jalcok1/practicum/images/Da_Brains_Assembled.jpg

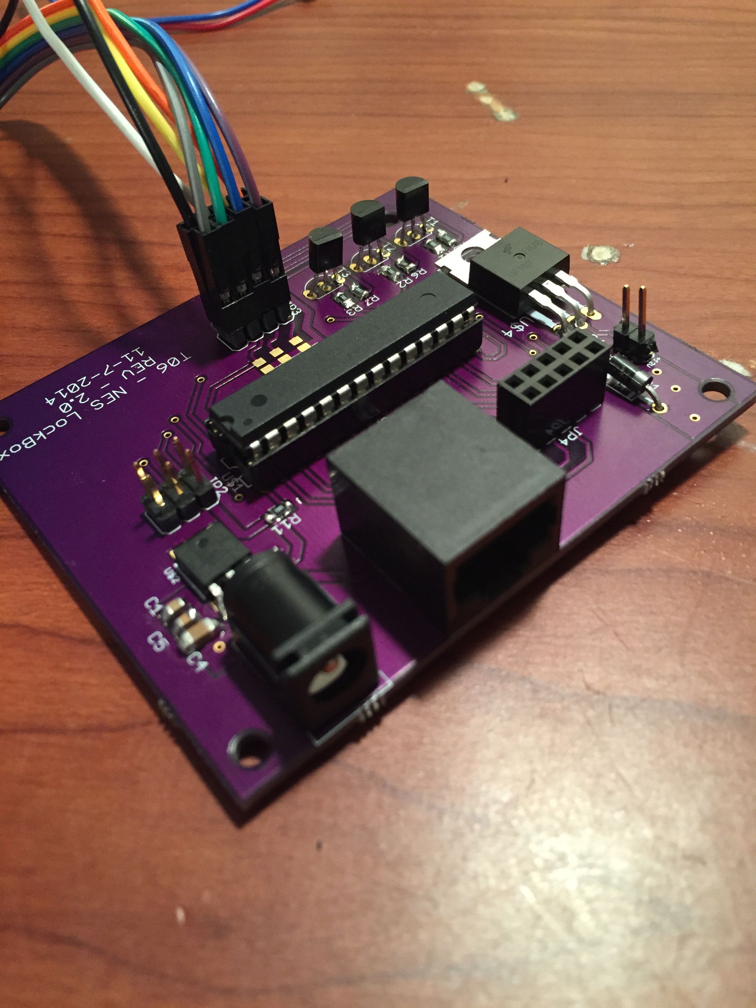
images/Da_Brains_Assembled.jpg
