jalcok1/practicum/images/LCD_and_DaBrains.jpg

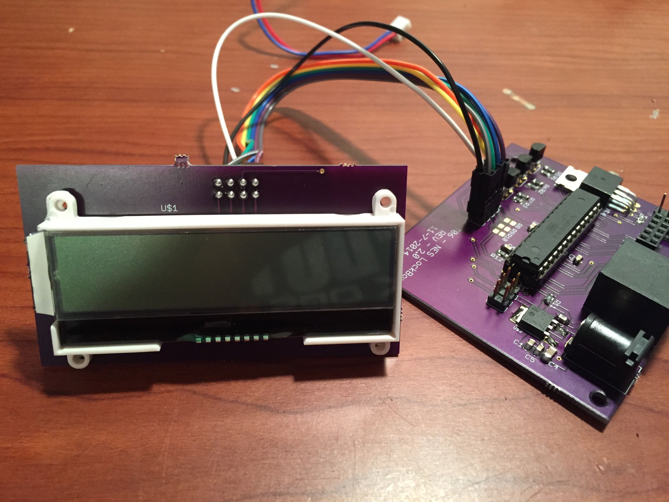
images/LCD_and_DaBrains.jpg
