jalcok1/practicum/411_assignments/LockBox_presentationRD.rtf

Presentation Rough Draft:

Problem or Need:
Novelty item, no real problem just cool!
when you want to lock stuff up and show off to youre friends that you have a hacked NES controller

Motivation:
Practicum project that meets the project specifications of:
Uses an ATMEL processor
Has at least one output
Has at least one input

Street cred! It shows off our awesome skills at making a wood box and hacking a NES controller

Objective:
See motivation item 1!

Alternatives:
Knock Box - T##?
Banks
Desk drawer
A box that locks - pick one

Requirements:
Only need to verify cost per unit requirements
other than that we met all the requirements stated in the PDS

Your Approach:
INITIAL RESEARCH
⁃ Chose ATMEL328P because it was the chip supported in classPC
⁃ carlos already had experience programming the 328
⁃ LCD selected as user feedback because LUIS already had one
⁃ HAS RGB ITS COOL!
⁃ Research for examples using ATMEL chip and a solenoid
⁃ selected components from those examples
ALLOCATION OF DUTYS/TASKS
PART 1 - ENSURE PARTS WORK
⁃ Luis I2C for LCD operation
⁃ Carlos NES controller can be modified
⁃ Chelsea Solenoid ckt and design make sure we can get it to work
⁃ Jeff create eagle library for parts selected from initial research
PART 2 - DESIGN
HARDWARE
Jeff fill out stuff
SOFTWARE
Luis, carlos and Saida
BOX is it a part of hardware?

Implemntation:
Main board:
LCD board:
Solenoid
Box
Latch
door
mounting
component locations
assembly
Main code (how much of it is original?)
LCD - use atmel TWImaster.c and TWImaster.h library
Solenoid - no idea fill some stuff out
Tools used:
eagle
atmel studio
lazer cutter
inkscape
gerbv
www.tinkercad.com
3D printer
Reflow oven
Soldering stations
scopes and other lab equipment
table saw
drill
magic marker - makes things look burnt again :0)
Prior Work:
Solenoid ckt
NES controller hack
TWImaster/library
Nintendo characters

Testing:
BREADBOARD/PROTOTYPE
Independently test each component to verify proper operation before integration into the system
As we started to integrate each component into the system we tested for proper operation

Tested Power supply for proper conversion of 12V to 3.3V - it did not over heat :-)

PCB
Integration by parts
test power
no issues
test LCD connection
in software LCD pin assignment and Solenoid assignment were overlapped
test NES controller
found a short to ground that would power down the chip when the controller was connected. There was a pin assignment error between the board and controller that was fixed by swapping the location of the power pin at the controller
test solenoid
no issues, there would have been an issue but it was resolved during the LCD testing above

SOLENOID
tested the solenoid for possible overheat
physically touched the solenoid and LDO during actuation and they did not overheat

BOX
Created a first cut of the box using the laser cutter, this first cut was to help visualize the final size of the box and get an idea of where the components will be mounted.
Resized box and discovered the material was too thin for the hardware selected to mount the components
Acquired thicker material but same dimensions
Mounted the solenoid the the box and acquired measurements for the latch that would be created using the 3D printer
Using scrap wood created a prototype door and box bottom to get door dimensions
Tested for proper door/latch/solenoid fit
Partially assembled the complete box (top of the box was loose) and adjusted the spring force that is applied to the door such that the solenoid could overcome that force.

CONTRIBUTIONS:

Jeff:
git support and setup
eagle - board layout, schematic, and library
box construction
box design
soldering and support (component placement/selection)
BOM

Luis:
Initial LCD code
Initial LCD eagle layout / schematic
Built LCD prototype board (bare copper)
Schematic/layout review
Box construction
Box design
Initial PCB board debug and testing
Soldering

Carlos:
NES controller prototype
Main code
final LCD code
LDO prototype
Code/debugging
Initial PCB bring up and debug
prototype system integration
Attempted to make a square hole with round drill bits :-)

Chelsea:
Solenoid prototyping
Homework
Really she did the documentation formatting rough drafts ect!!!!
Soldering
Meeting minutes / organization

Saida:
Created custom characters for LCD
BOM
Soldering

LESSONS LEARNED:
let each team member speak to what they learned over the project………

DONT FORGET TO ADD UNEXPECTED EVENTS:
pull down for LED backlight
jumper cables for power and ethernet
