jalcok1/practicum/MeetingMinutes/111214.docx

11/12/14 Meeting Minutes

Action Items

- Assignment 4: Block Diagram
  - ASSIGNED TO Carlos
- Schedule/Gannt Chart Update by Monday
  - ASSIGNED TO Chelsea
  - Saida will be added to BOM with jeff
  - Adding up and down arrows - Saida

Immediate Tasks

- Saida: Test dragon board and LCD driver
