jalcok1/practicum/images/Da_Brains_Blank.jpg

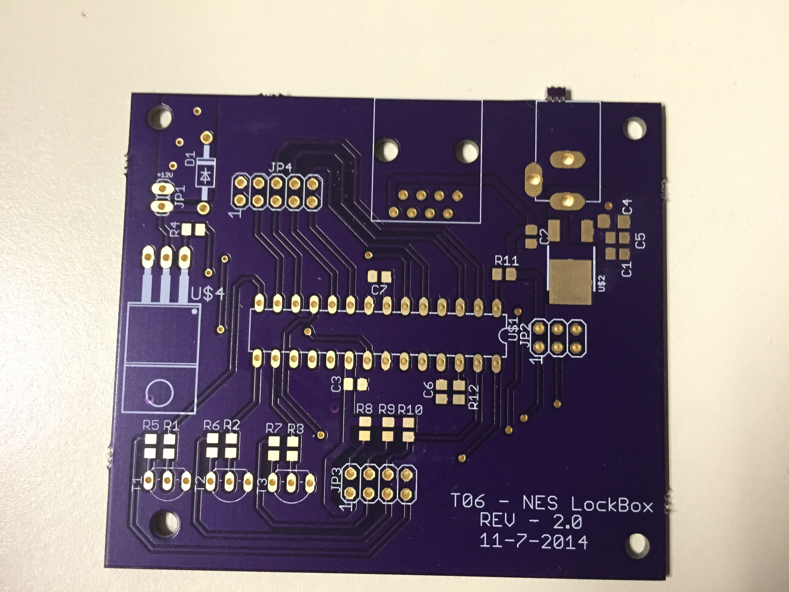
images/Da_Brains_Blank.jpg
