jalcok1/practicum/images/FlowChart.png

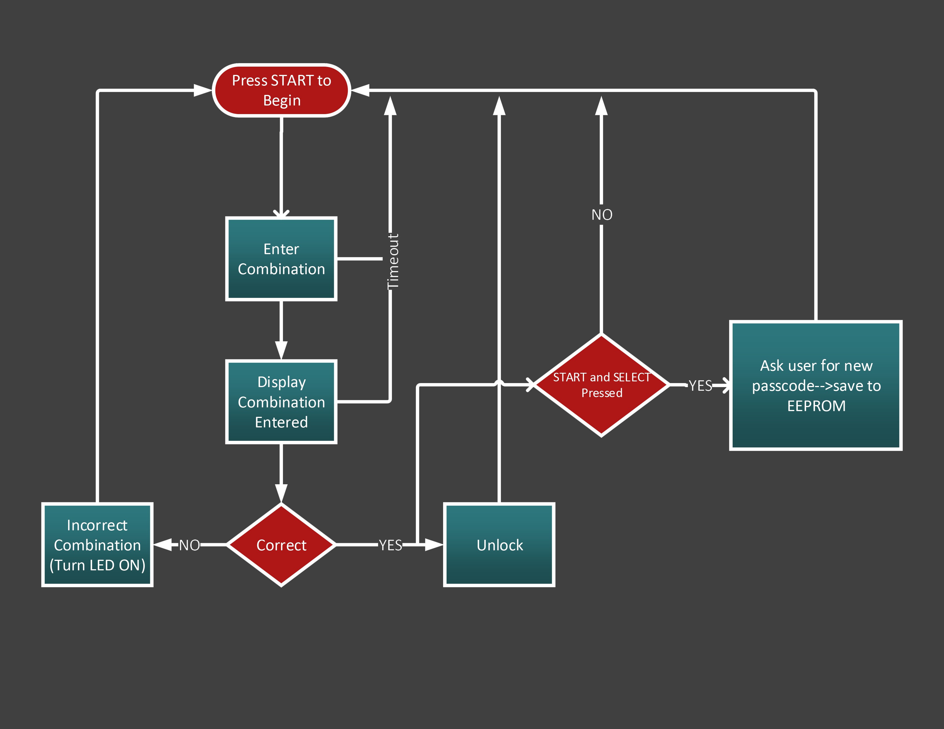
images/FlowChart.png
