jalcok1/practicum/images/Konami_Code.png

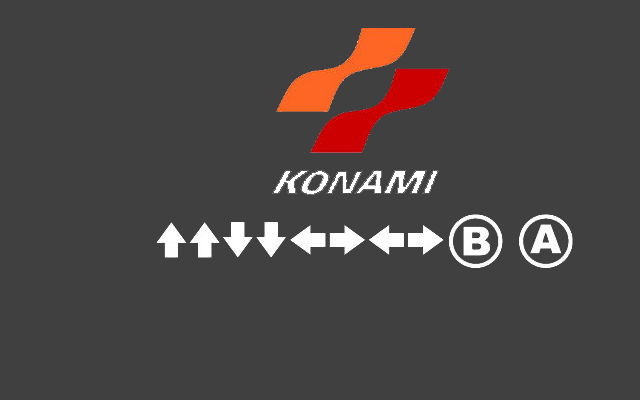
images/Konami_Code.png
