jalcok1/practicum/images/LCD_Break_Out_Board.jpg

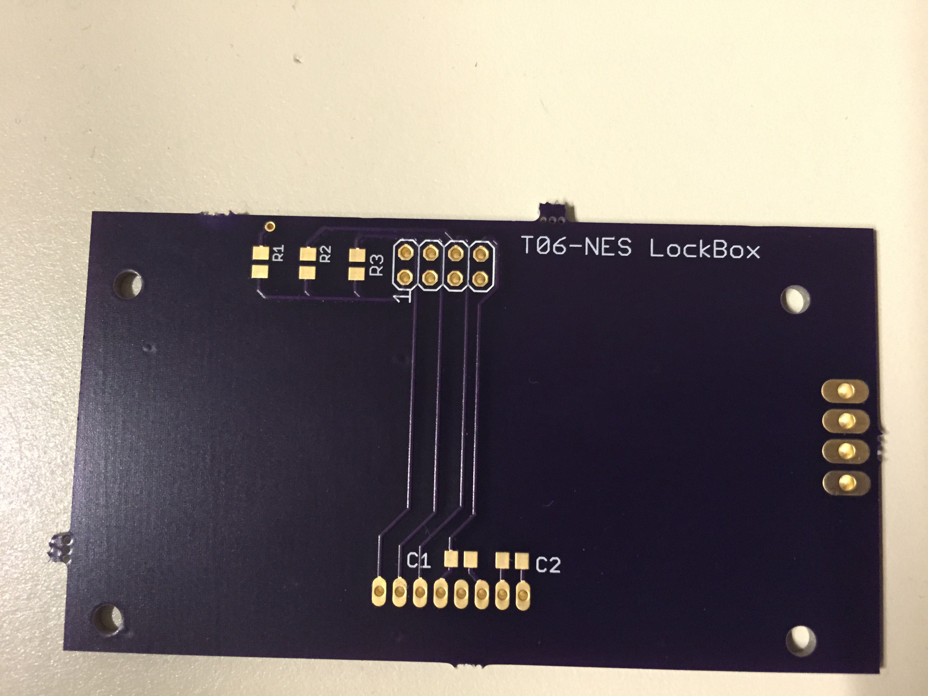
images/LCD_Break_Out_Board.jpg
