jalcok1/practicum/images/LDO.jpg

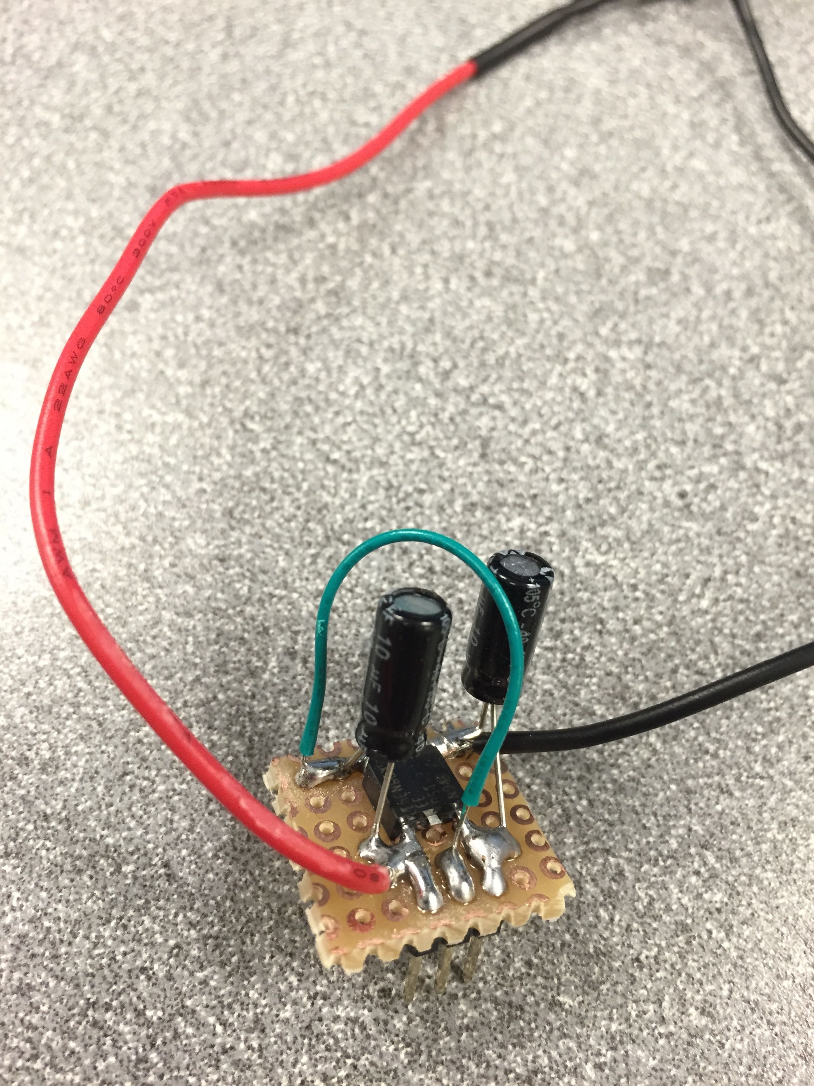
images/LDO.jpg
