jalcok1/practicum/images/LockBox1.jpg

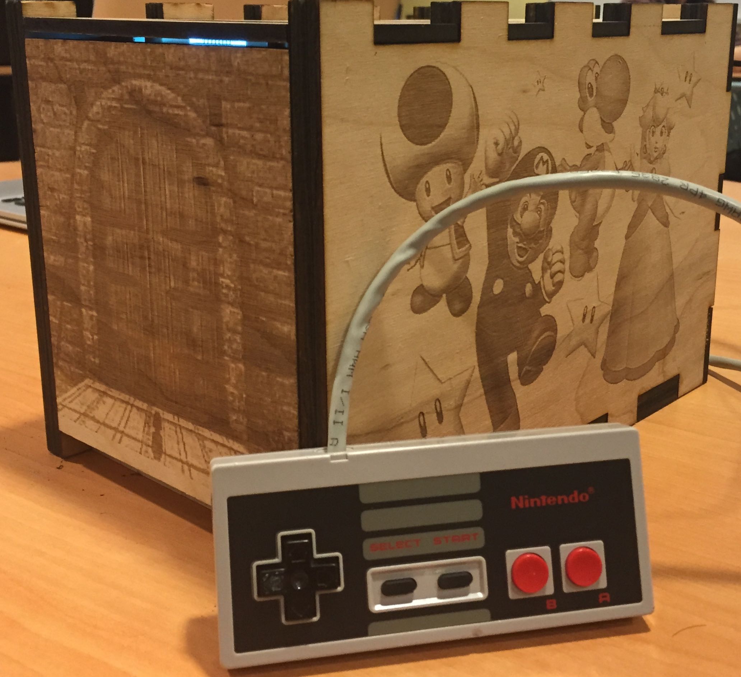
images/LockBox1.jpg
