jalcok1/practicum/images/LockBox2.jpg

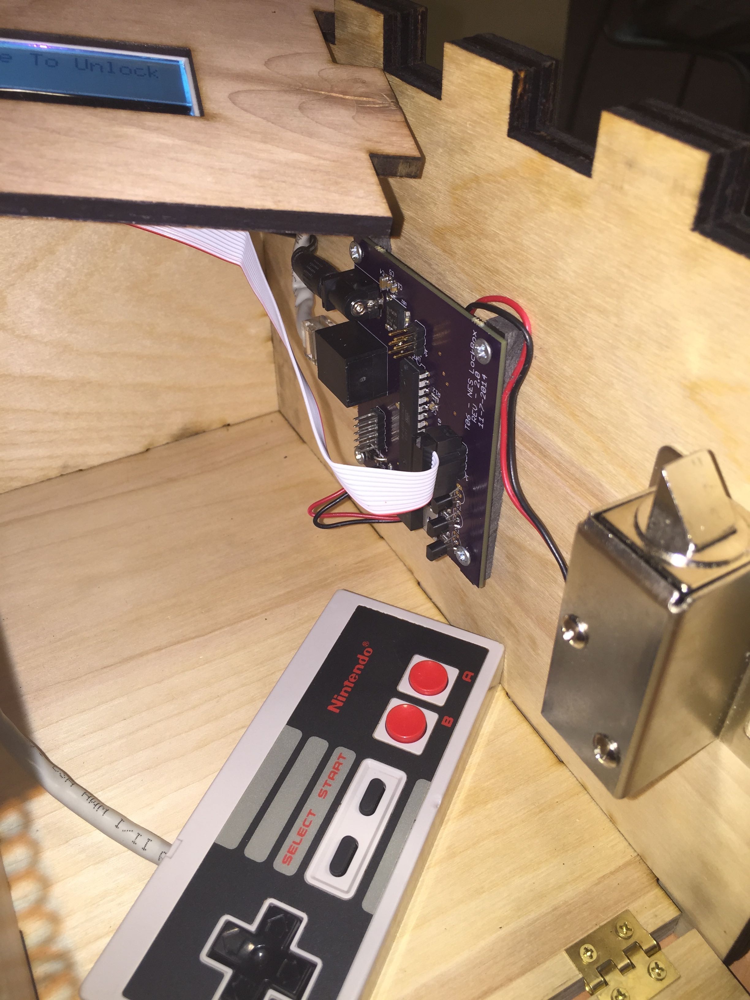
images/LockBox2.jpg
