jalcok1/practicum/images/LockBox3.jpg

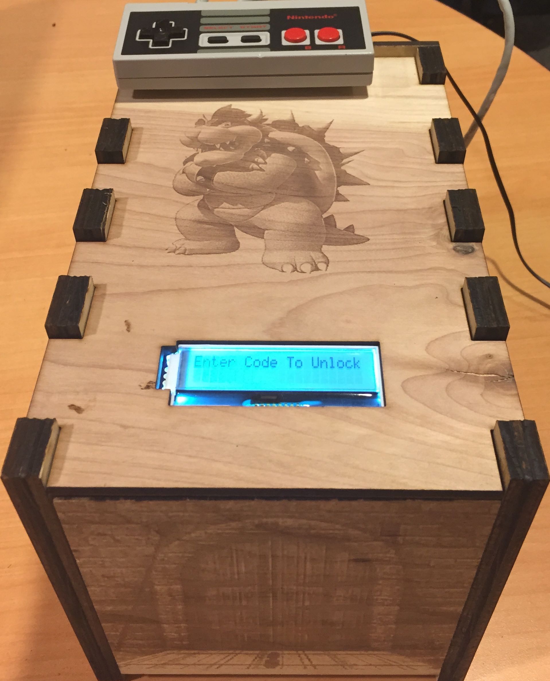
images/LockBox3.jpg
