jalcok1/practicum/images/LockBox4.jpg

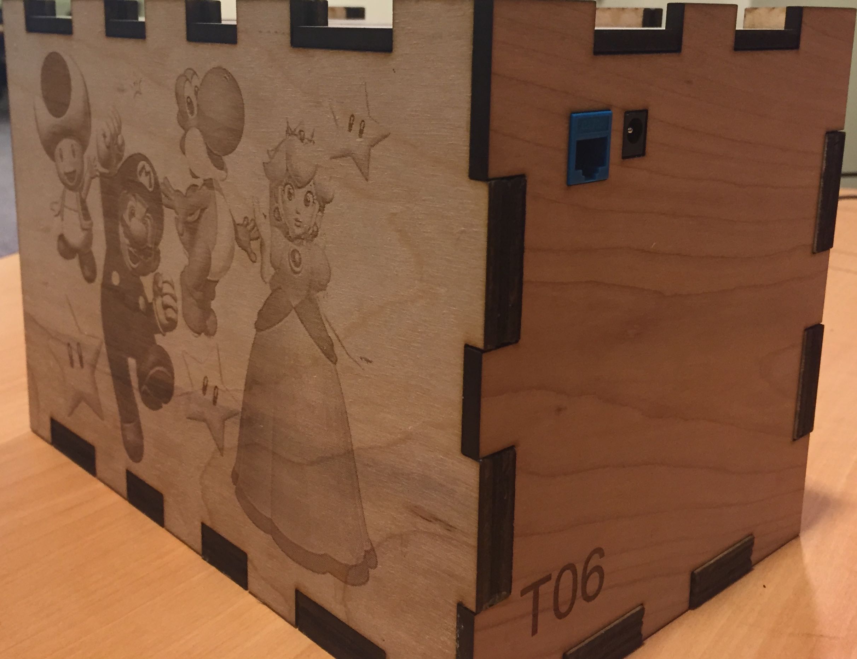
images/LockBox4.jpg
