jalcok1/practicum/images/LockBox5.jpg

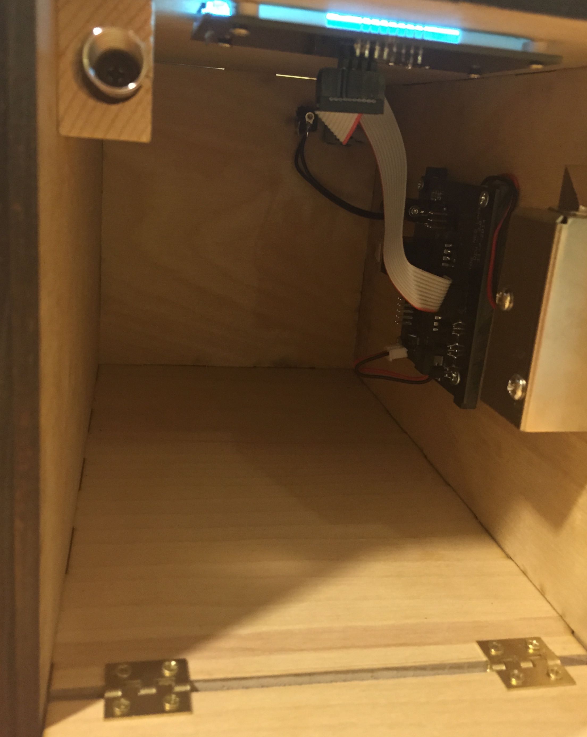
images/LockBox5.jpg
