jalcok1/practicum/images/Solenoid_Circuitry.jpg

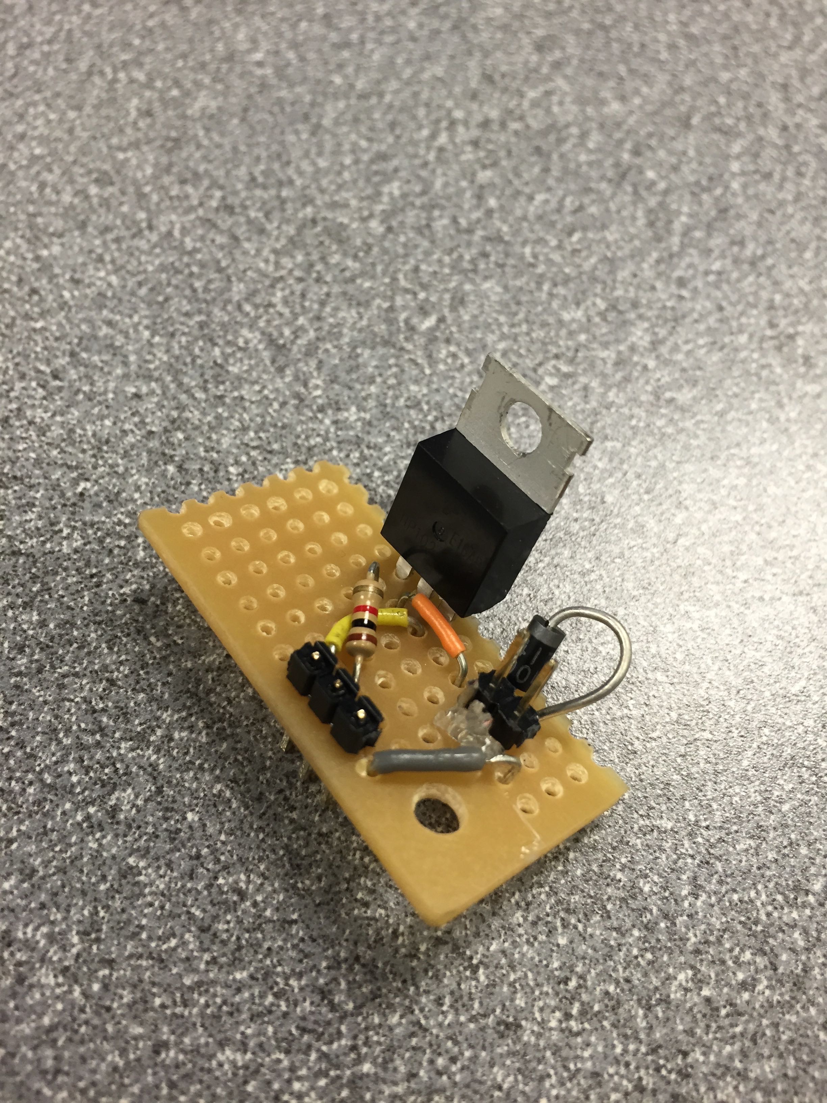
images/Solenoid_Circuitry.jpg
