jalcok1/practicum/images/Working_Prototype.png

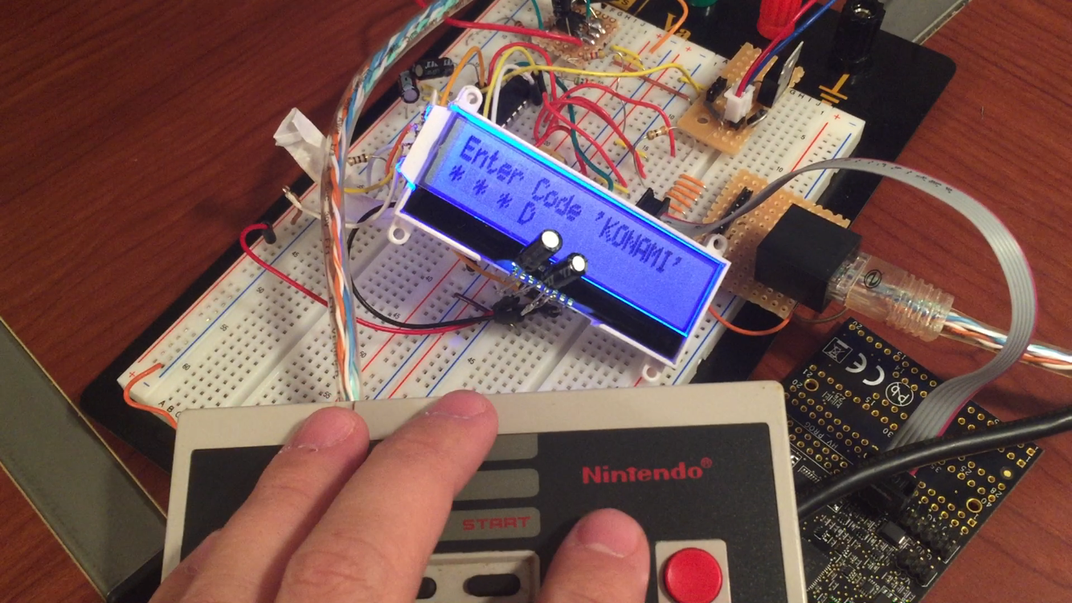
images/Working_Prototype.png
