jalcok1/practicum/eagle/T06_LockBox_bom.xlsx

Sheet: T06_LockBox_Bom1
Part | Device | Package | Value | Voltage/Power Rating | Description | Manufacturer | Manufacturer Part Number | Digikey Part Number | ADAFRUIT | Quantity/Extended Price
 |  |  |  |  |  |  |  |  |  | 1 | 10 | 100 | 1000
C1 | C | C0805 | 330pF | 25V | CAPACITOR - Ceramic | Murata Electronics North America | GRM21BR71E334KA01L | 490-1677-1-ND |  | $0.26 | $2.18 | $10.88 | $63.92
C2 | C | C0805 | 10uF | 25V | CAPACITOR - Ceramic | Samsung Electro-Mechanics America, Inc | CL31B106KAHNNNE | 1276-1804-1-ND |  | $0.34 | $2.80 | $14.00 | $82.25
C3 | C | C0805 | 1uF | 25V | CAPACITOR - Ceramic | Samsung Electro-Mechanics America, Inc | CL21B105KAFNNNE | 1276-1066-1-ND |  | $0.12 | $0.87 | $3.97 | $21.66
C4 | C | C1206 | 10uF | 10V | CAPACITOR - Ceramic | Samsung Electro-Mechanics America, Inc | CL21B106KPQNFNE | 1276-2934-1-ND |  | $0.32 | $2.80 | $14.00 | $92.00
C5 | C | C0805 | 1uF | 10V | CAPACITOR - Ceramic | Samsung Electro-Mechanics America, Inc | CL21B105KPFNNNE | 1276-1275-1-ND |  | $0.10 | $0.73 | $3.34 | $18.21
C6 | C | C0805 | 1uF | 10V | CAPACITOR - Ceramic | Samsung Electro-Mechanics America, Inc | CL21B105KPFNNNE | 1276-1275-1-ND |  | $0.10 | $0.73 | $3.34 | $18.21
C7 | C | C0805 | 1uF | 10V | CAPACITOR - Ceramic | Samsung Electro-Mechanics America, Inc | CL21B105KPFNNNE | 1276-1275-1-ND |  | $0.10 | $0.73 | $3.34 | $18.21
D1 | 1N4004 | DO41-10 | 1N4004 | 400V | DIODE - GEN PURPOSE | Diodes Incorporated | 1N4004-T | 1N4004DICT-ND |  | $0.13 | $1.20 | $7.88 | $26.27
JP1 | PINHD | 1X02 | Sol_ctrl |  | PIN HEADER - 1X02 Male
JP2 | PINHD | 2X03 | ICSP |  | PIN HEADER - 2X03 Male | FCI | 67996-206HLF | 609-3210-ND |  | $0.40 | $3.77 | $26.36 | $188.30
JP3 | PINHD | 2X04 | LCD |  | PIN HEADER - 2X04 Male | FCI | 67996-408HLF | 609-3391-ND |  | $0.32 | $3.07 | $21.51 | $153.65
JP4 | PINHD | 2X05 | UNUSED |  | PIN HEADER - 2X05 Male | FCI | 67997-410HLF | 609-3243-ND |  | $0.26 | $2.48 | $17.16 | $118.80
R1 | R | R0805 | 10k | 1/8W | RESISTOR | Vishay | CRCW080510K0FKEA | 541-10.0KCCT-ND |  | N/A | $0.97 | N/A | $20.36
R2 | R | R0805 | 10k | 1/8W | RESISTOR | Vishay | CRCW080510K0FKEA | 541-10.0KCCT-ND |  | N/A | $0.97 | N/A | $20.36
R3 | R | R0805 | 10k | 1/8W | RESISTOR | Vishay | CRCW080510K0FKEA | 541-10.0KCCT-ND |  | N/A | $0.97 | N/A | $20.36
R4 | R | R0805 | 1k | 1/8W | RESISTOR | Panasonic Electronic Components | ERJ-6ENF1001V | P1.00KCCT-ND |  | $0.10 | N/A | $2.19 | $8.00
R5 | R | R0805 | 150 | 1/8W | RESISTOR | Vishay | CRCW0805150RFKEA | 541-150CCT-ND |  | N/A | $0.97 | N/A | $20.36
R6 | R | R0805 | 33 | 1/8W | RESISTOR | Vishay | CRCW080533R0FKEA | 541-33.0CCT-ND |  | N/A | $0.97 | N/A | $20.36
R7 | R | R0805 | 33 | 1/8W | RESISTOR | Vishay | CRCW080533R0FKEA | 541-33.0CCT-ND |  | N/A | $0.97 | N/A | $20.36
R8 | R | R0805 | 10k | 1/8W | RESISTOR | Vishay | CRCW080510K0FKEA | 541-10.0KCCT-ND |  | N/A | $0.97 | N/A | $20.36
R9 | R | R0805 | 4.7k | 1/8W | RESISTOR | Panasonic Electronic Components | ERJ-6GEYJ472V | P4.7KACT-ND |  | $0.10 | N/A | $1.49 | $5.44
R10 | R | R0805 | 4.7k | 1/8W | RESISTOR | Panasonic Electronic Components | ERJ-6GEYJ472V | P4.7KACT-ND |  | $0.10 | N/A | $1.49 | $5.44
R11 | R | R0805 | 10k | 1/8W | RESISTOR | Vishay | CRCW080510K0FKEA | 541-10.0KCCT-ND |  | N/A | $0.97 | N/A | $20.36
R12 | R | R0805 | Undecidd |  | RESISTOR
T1 | 2N3904 | TO92-BCE | 2N3904 |  | NPN TRANSISTOR | Fairchild | 2N3904BU | 2N3904FS-ND |  | $0.19 | $1.73 | $11.34 | $37.80
T2 | 2N3904 | TO92-BCE | 2N3904 |  | NPN TRANSISTOR | Fairchild | 2N3904BU | 2N3904FS-ND |  | $0.19 | $1.73 | $11.34 | $37.80
T3 | 2N3904 | TO92-BCE | 2N3904 |  | NPN TRANSISTOR | Fairchild | 2N3904BU | 2N3904FS-ND |  | $0.19 | $1.73 | $11.34 | $37.80
U$1 | ATMEGA328 | DIL28-3 | ATMEGA328 |  | Atmel 8-bit Microcontroller | Atmel | ATMEGA328P-PU | ATMEGA328PPU-ND |  | $3.74 | $33.38 | $273.74 | $1869.45
U$2 | LD29150DT33R | DPAK | LD29150DT33R |  | LD29150 - 1.5A, Very low drop voltage regulator | STMicroelectronics | LD29150DT50R | 497-3468-1-ND |  | $1.02 | $8.92 | $68.67 | $407.55
U$3 | PJ-102A | PJ-102A | PJ-102A |  | DC POWER JACK - 2.1mm center pin diameter | CUI inc | PJ102A | CP-102A-ND |  | $1.00 | $7.00 | $47.00 | $340.00
U$4 | TIP102 | T0220-3 | TIP102 |  | TIP102 - NPN Darlington Transistor | Fairchild | TIP102 | TIP102-ND |  | $0.96 | $8.52 | $67.35 | $412.35
U$6 | ETHERNET_JACK | RJ-45 | ETHERNET_JACK |  | 8-Pin eithernet jack | FCI | 54602-908LF | 609-1046-ND |  | $0.57 | $5.35 | $41.01 | $294.20
 | SN74HC148D | SOIC-16 | SN74HC148D |  | IC 8-3 PRIORITY ENCODER | Texas Insturmants | SN74HC148DR | 296-26468-1-ND |  | $0.49 | $3.83 | $26.35 | $135.05
 | PNHD | 1X10 |  |  | 10POS SIL VERTICAL PIN HEADER | Harwin Inc | M20-9991046 | 952-1843-ND |  | $0.35 | $3.33 | $23.28 | $166.25
 | IC-SOCKET | DIL28-3 |  |  | IC SOCKET - 28POS | Assmann WSW Components | A28-LC-7-TT-R | AE10286-ND |  | $0.43 | $3.99 | $30.59 | $219.45
 | SOLENOID |  |  | 12V / 500mA | Lock-style Solenoid 12VDC |  |  |  | 1512 | $14.95 | $13.46 | $11.96
 | NES CONTROLLER |  |  |  | Original Nintendo Controler | Nintendo | N/A | N/A | N/A | $7.00
 | LCD |  |  |  | LCD Display - RGB LED Backlit | Newhaven Display Intl | NHD-C0220BIZ-FS(RGB)-FBW-3VM | NHD-C0220BIZ-FS(RGB)-FBW-3VM-ND | N/A | $12.00 | $105.60 | $948.00 | $8875.00
 | PCB - Main |  |  |  | PCB - LockBox Main board | OSHPark |  |  |  | 12.76666667 | N/A | N/A | N/A
 | PCB - LCD |  |  |  | PCB - LCD screen | OSHPark |  |  |  | 8.866666667 | N/A | N/A | N/A
W1 | PCB to LCD Cable |  |  |  | Main to LCD ribbon cable - 10POS | 3M | 3365/10 300SF | MC10G-5-NG |  | 2.12
 | IDC Socket |  |  |  | Main to LCD ribbon cable connector - 10POS | CNC TECH | 3030-10-0102-00 | 1175-1435-ND |  | 0.33 | 3.15 | 22.05 | 157.5
j5 | RJ45 Jack |  |  |  | RJ45 Keystone jack | PCH Cables | 101703BE |  |  | 2.05

Sheet: Module Cost
Main Board |  |  |  |  | LCD Board
QTY | PART | Value | Voltage/Power Rating | Cost | QTY | PART | Value | Voltage/Power Rating | Cost
1 | ATMEGA328 | ATMEGA328 |  | $3.74 | 1 | LCD |  |  | $12.00
1 | C | 330pF | 25V | $0.26 | 1 | PINHD | 2X04 |  | $0.32
1 | C | 10uF | 25V | $0.34 | 1 | R | 10K | 1/4W | $0.10
1 | C | 1uF | 25V | $0.12 | 2 | R | 4.7K | 1/4W | $0.20
3 | C | 1uF | 10V | $0.30 | 2 | C | 1uF | 10V | $0.20
1 | PINHD | 1X02 | Sol_ctrl | $0.07 | 7 |  |  |  | $12.82
1 | PINHD | 2X03 | ICSP | $0.40
1 | PINHD | 2X04 | LCD | $0.32 | Nintendo Controller
1 | PINHD | 2X05 | UNUSED | $0.26 | QTY | PART | Value | Voltage/Power Rating | Cost
4 | R | 10K | 1/8W | $0.39
2 | R | 4.7K | 1/8W | $0.20 | 1 | NES CONTROLLER |  |  | $7.00
1 | R | 1K | 1/8W | $0.10 | 1 | ETHERNET CABLE |  |  | $1.78
1 | R | 150 | 1/8W | $0.10 | 1 | SN74HC148D |  |  | $0.57
1 | R | 33 | 1/8W | $0.10 | 3 |  |  |  | $9.35
3 | 2N3904 | 2N3904 |  | $0.57
1 | LD29150DT33R | LD29150DT33R |  | $1.02
1 | PJ-102A | PJ-102A |  | $1.00 | THE BOX
1 | TIP102 | TIP102 |  | $0.96 | QTY | PART | DESCRIPTION |  | Cost
1 | ETHERNET_JACK | ETHERNET_JACK |  | $0.57
27 |  |  |  | $10.81 | 1 | WOOD | 1/2in 2ftx4ft plywood |  | $16.79
 |  |  |  |  | 1 | HINGE | small piano hinges |  | $1.97
 |  |  |  |  | 1 | SCREWS | 8 small wood screws |  | $2.00
 |  |  |  |  | 1 | LATCH | 3D Printed latch |  | $0.17
Total Parts | Total Cost |  |  |  | 1 | PJ-102A | Barrel power jack |  | $1.00
46 | $82.71 |  |  |  | 1 | RJ45 | Ethernet jeck |  | $0.57
 |  |  |  |  | 1 | PCB - LCD | LCD board + components |  | $21.68
 |  |  |  |  | 1 | Solenoid |  |  | $14.95
 |  |  |  |  | 1 | PCB - Main | Main board + components |  | $23.58
 |  |  |  |  | 9 |  |  |  | $82.71
