jalcok1/practicum/latch.stl

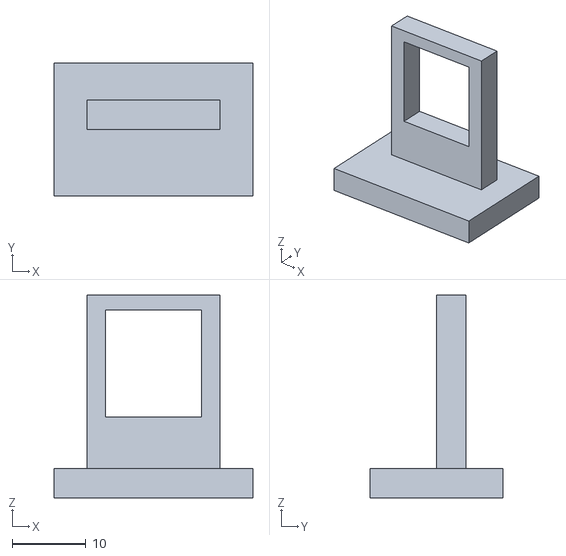
[picture p19: CAD file, 2014-11-23]
latch.stl
27.0 x 18.0 x 27.5
