jalcok1/practicum/(commit log)

2014-11-12 Adding LockBox BOM
    [T06_LockBox_Bom-Exl.xlsx]
2014-11-14 adding original LCD driver code
2014-11-15 adding images
    [arduino_2_328_PinOut.xlsx]
2014-11-15 Correct One(T06)
    [T06_LockBox_Bom-Exl_current.xlsx]
2014-11-15 Started formatting changes to the BOM
    [T06_LockBox_Bom-Exl_current.xlsx]
2014-11-15 removed redundant bom file, and changed the current bom file name to match project file naming conventions.
    [T06_LockBox_Bom-Exl.xlsx, T06_LockBox_bom.xlsx]
2014-11-15 Small changes
    [T06_LockBox_Bom-Exl_current.xlsx]
2014-11-16 Updated BOM
    [T06_LockBox_Bom-Exl_current.xlsx, T06_LockBox_bom.xlsx]
2014-11-16 removing duplicate BOM
    [T06_LockBox_Bom-Exl_current.xlsx]
2014-11-16 removed old BOMs, restored correct BOM that was accidently deleted
    [T06_LockBox_Bom-Exl.xlsx, T06_LockBox_Bom-Exl_current.xlsx, T06_LockBox_bom.xlsx]
2014-11-16 Added more data to the BOM
    [T06_LockBox_bom.xlsx]
2014-11-16 Added cost for main and lcd pcb
    [T06_LockBox_bom.xlsx]
2014-11-18 Adding gerber file for main board stencil
2014-11-19 updated capacitor values with appropiate voltage ratings. changed R8-R10 and No place
2014-11-23 added latch.stl file for 3d printing
    [latch.stl]
2014-11-24 code updates
    changed how the program prints the “home” message to LCD
2014-11-24 Adding latest version of testplan, this requires final review and final test case of LCD screen.
2014-12-10 more changes to the bom
    [T06_LockBox_bom.xlsx]
2014-12-10 sure
    i did it a week ago, right….
2014-12-10 added full prototype image
2014-12-11 added flow chart
2014-12-11 upadted the BOM; main, lcd and cable BOMS added
    [T06_LockBox_bom.xlsx]
2014-12-11 updated flow chart
2014-12-11 finalized the BOM
    [T06_LockBox_bom.xlsx]
